Nathan-F04/SaRQ-4th-Year-Project-/Python/yolo/email scripts/example.jpg

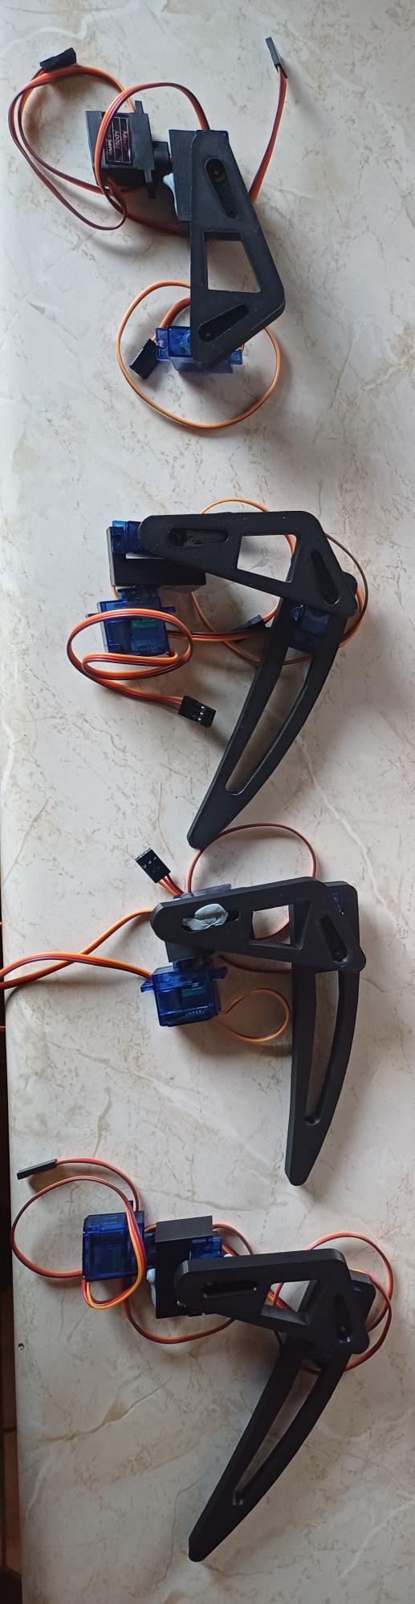
Python/yolo/email scripts/example.jpg
