Nathan-F04/SaRQ-4th-Year-Project-/PDFs/Poster/SaRQ Poster GitHub.pdf

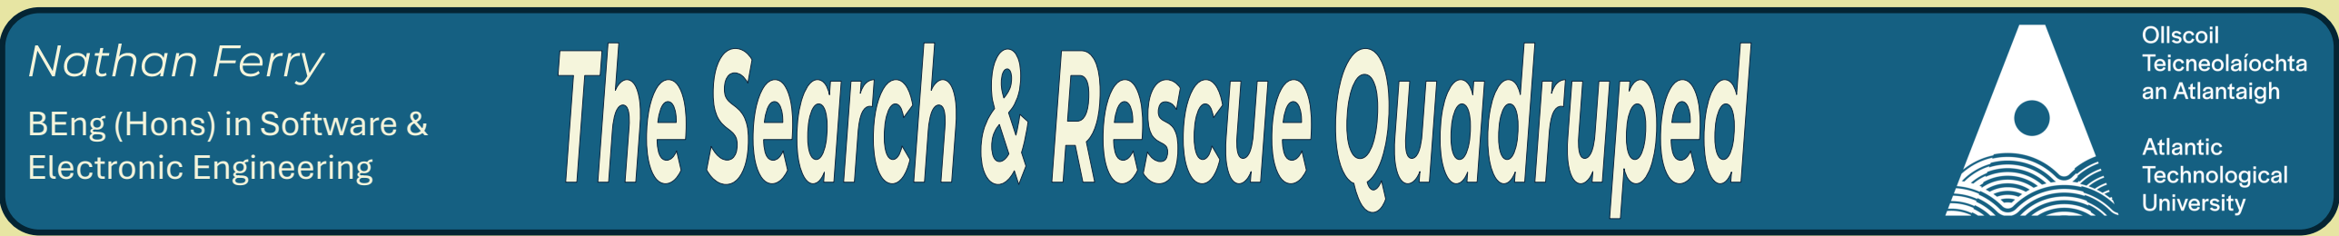
[picture p79: figure]
BEng (Hons) in Software & Electronic Engineering
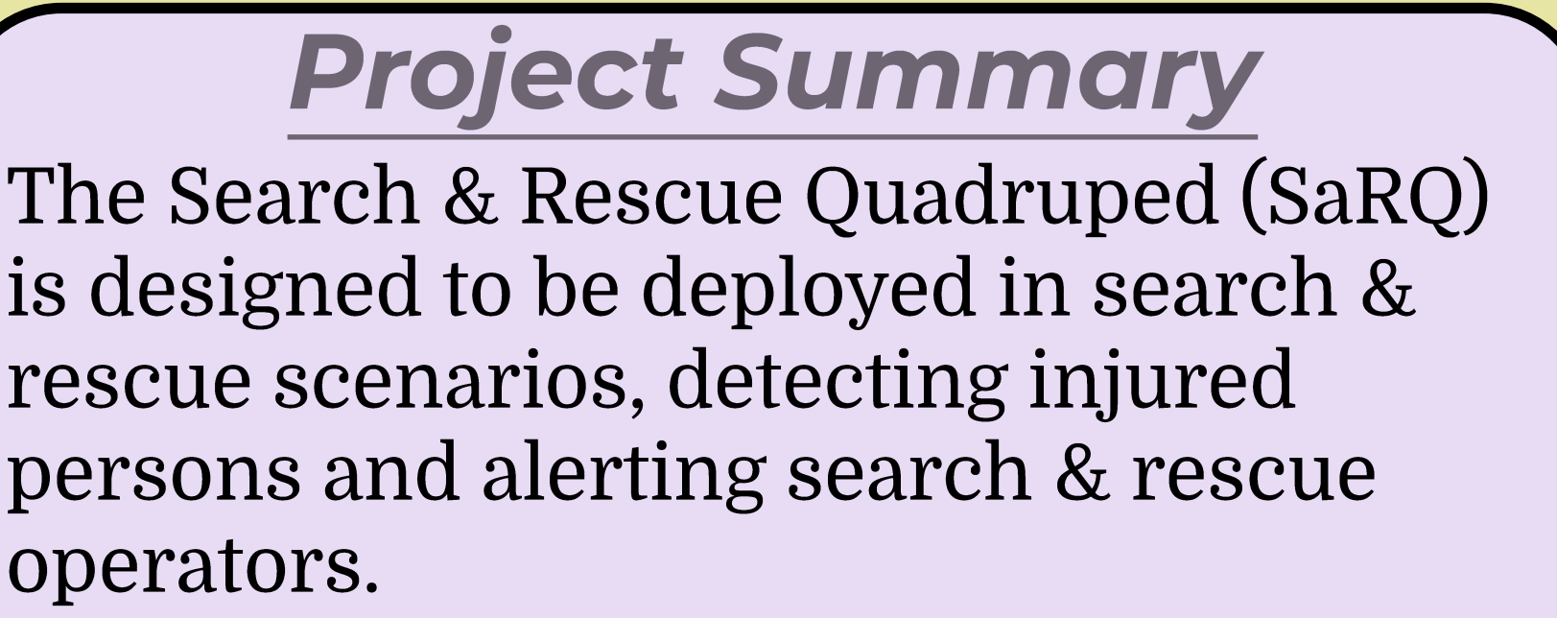
[picture p80: figure]
Project Summary; The Search & Rescue Quadruped (SaRQ) is designed to be deployed in search & rescue scenarios, detecting injured persons and alerting search & rescue operators.

## Architecture Diagram

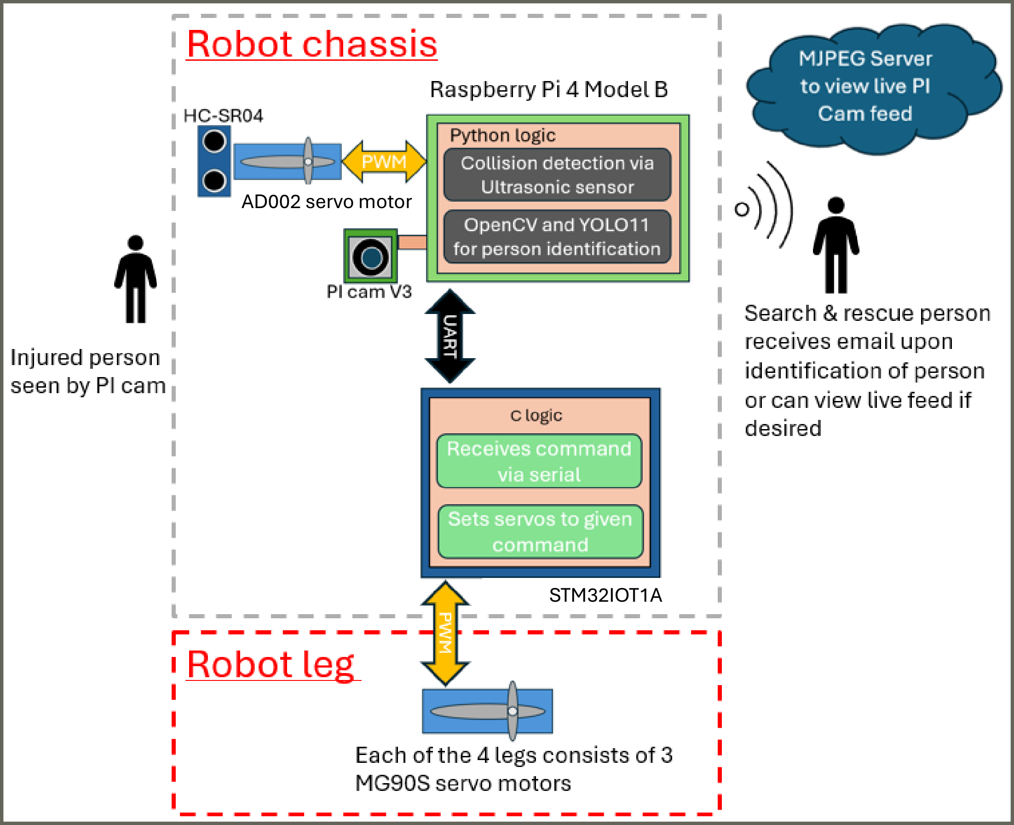
[picture p81: figure]
Yap Yap Yap; STM32IOT1A; AD002 servo motor
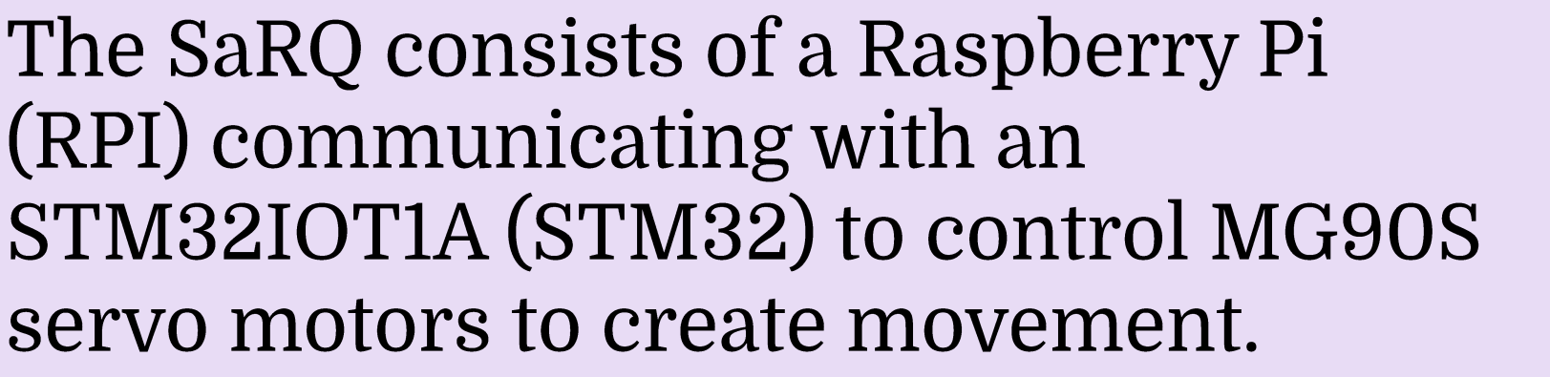
[picture p82: figure]
The SaRQ consists of a Raspberry Pi (RPI) communicating with an STM32IOT1A (STM32) to control MG90S servo motors to create movement.
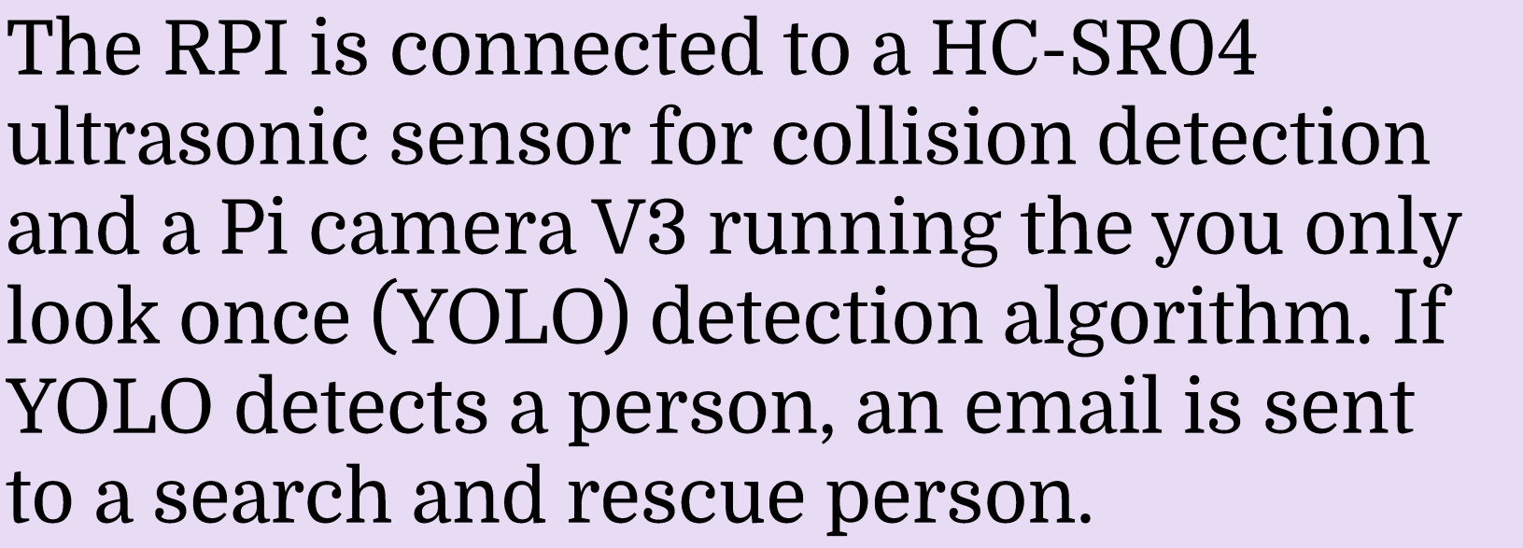
[picture p83: figure]
The RPI is connected to a HC; and a Pi camera V3 running the you only; YOLO detects a person, an email is sent to a search and rescue person.

ultrasonic sensor for collision detection

look once (YOLO) detection algorithm. If

The SaRQ’s live feed through a motion jpeg (MJPEG) server is also available.

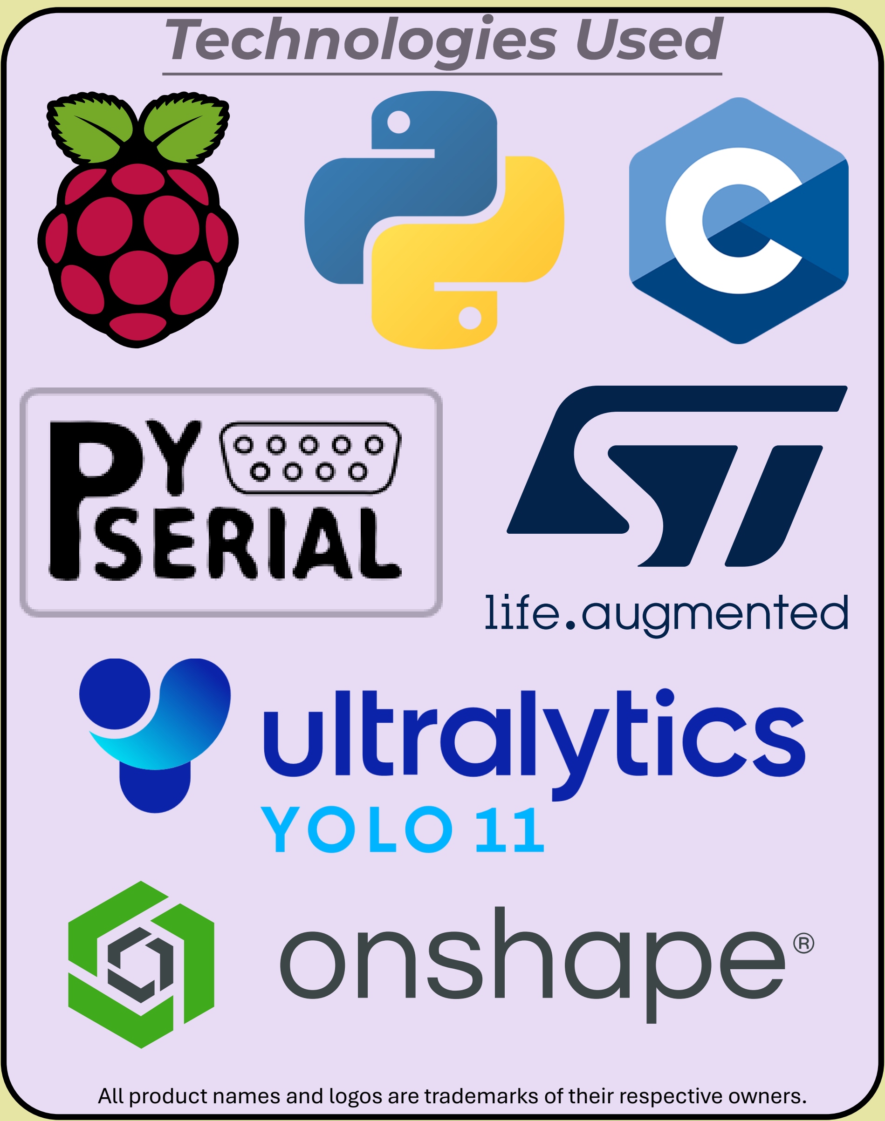
[picture p84: figure]
Technologies Used
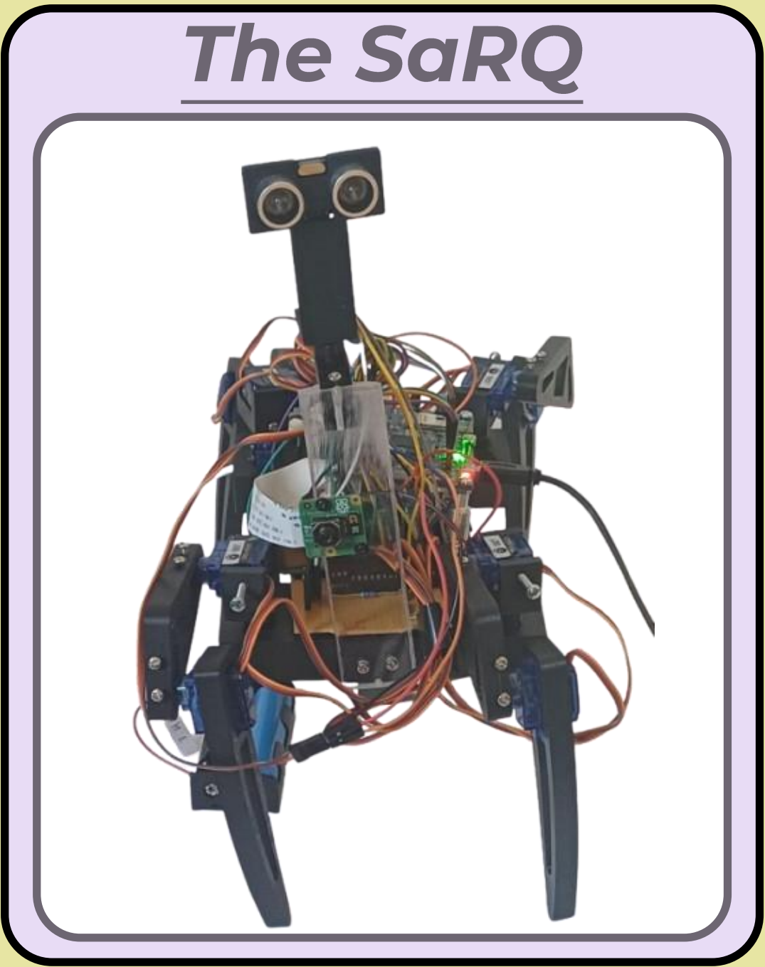
[picture p85: figure]
The SaRQ
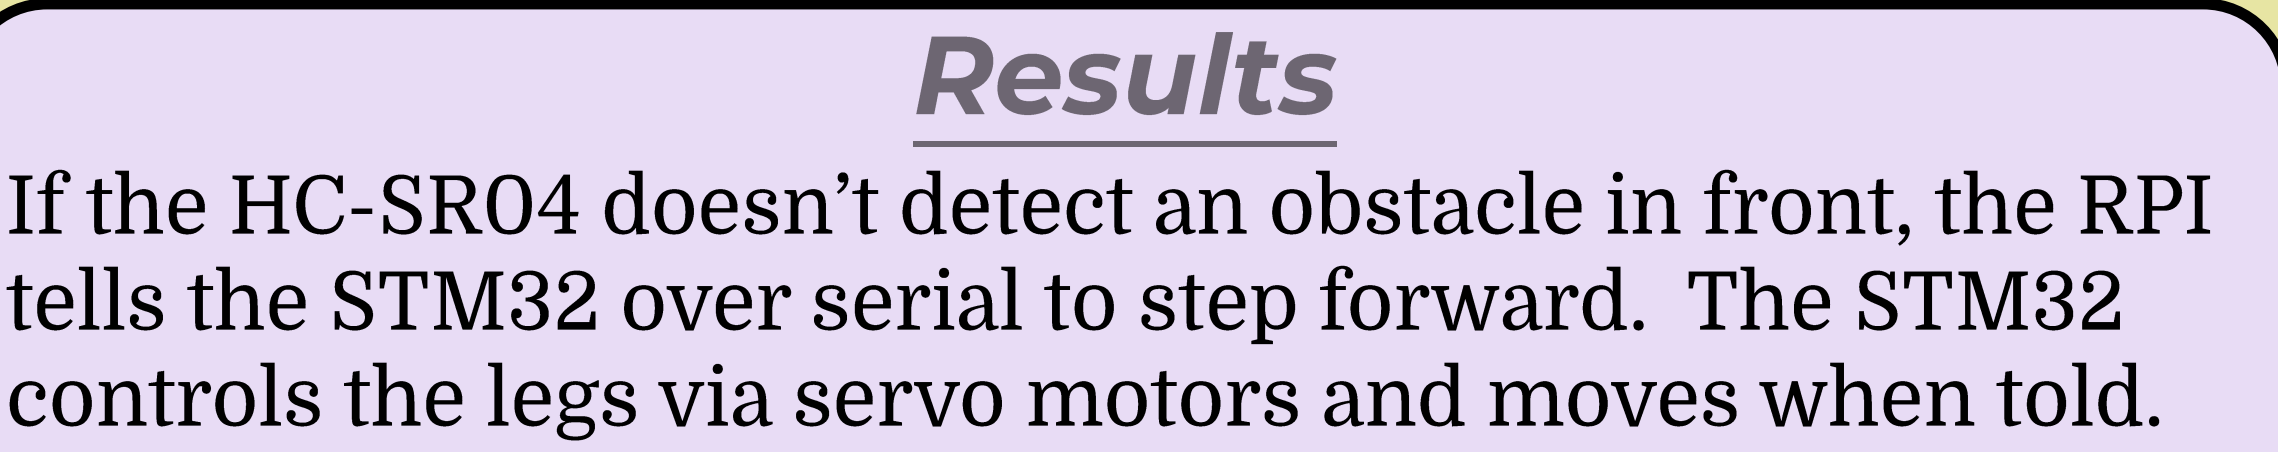
[picture p86: figure]
Results

If the HC -SR04 doesn’t detect an obstacle in front, the RPI tells the STM32 over serial to step forward. The STM32 controls the legs via servo motors and moves when told.

If an obstacle is detected, the HC | -SR04 rotates via an
SG90 servo motor | , taking readings on the left and right of
the SaRQ for the RPI to decide the best direction to move.

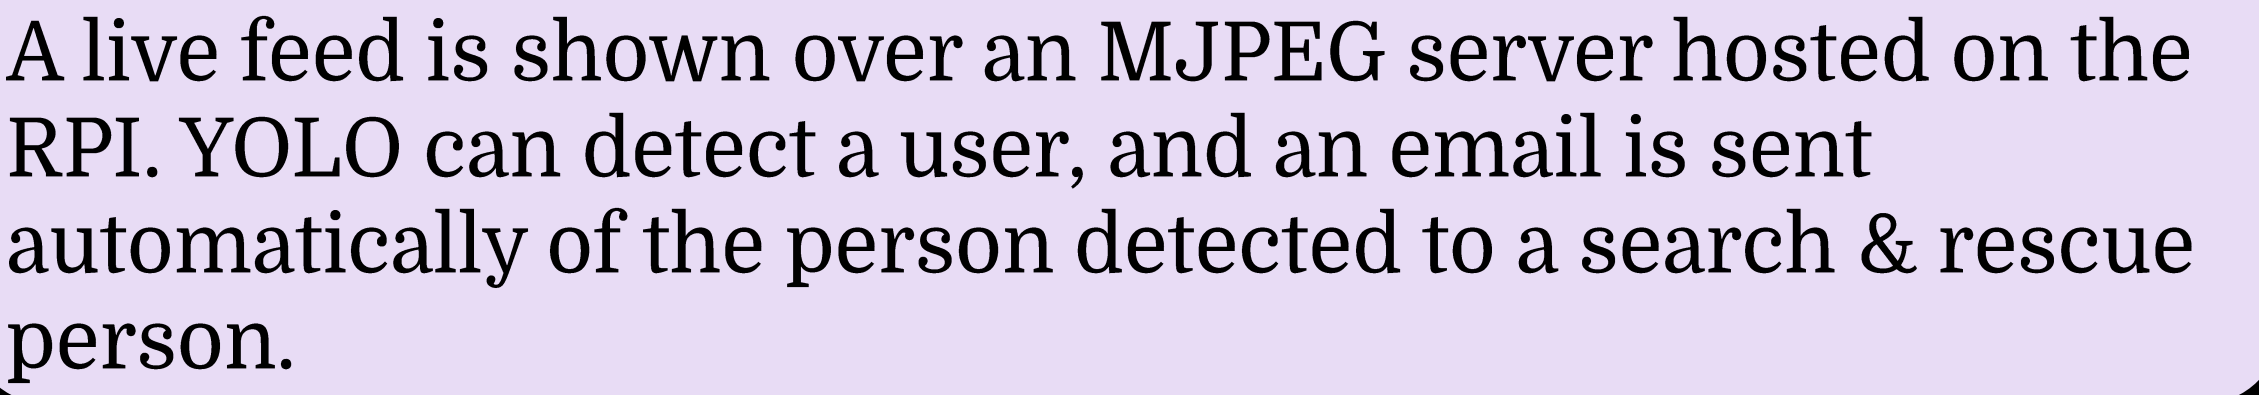
[picture p87: figure]
person.

A live feed is shown over an MJPEG server hosted on the RPI. YOLO can detect a user, and an email is sent automatically of the person detected to a search & rescue

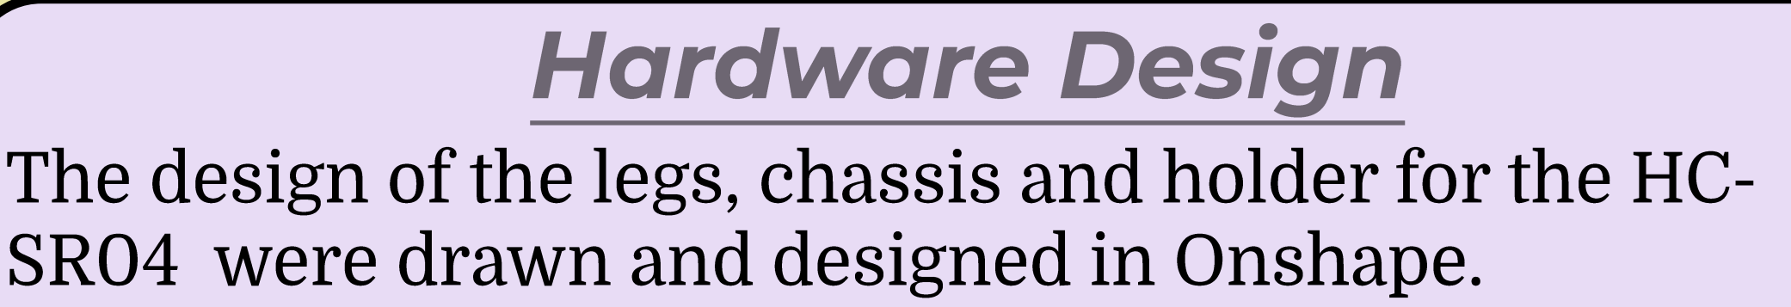
[picture p88: figure]
Hardware Design

The design of the legs, chassis and holder for the HC | -
SR04 were drawn and designed in Onshape.

A Perspex mount holds the Pi camera on the front, along with a servo motor that rotates the HC -SR04.

A series of M3 screws hold the SaRQ, where the holes were drilled and tapped, providing a better grip.

A brown stripboard sits beneath the RPI and STM32, containing a series of headers to help manage the number of servo motor connections, aiding wire management.

The Search & Rescue Quadruped Nathan Ferry

All product names and logos are trademarks of their respective owners.
