Nathan-F04/SaRQ-4th-Year-Project-/PDFs/Presentation Slides/SaRQ presentation.pdf

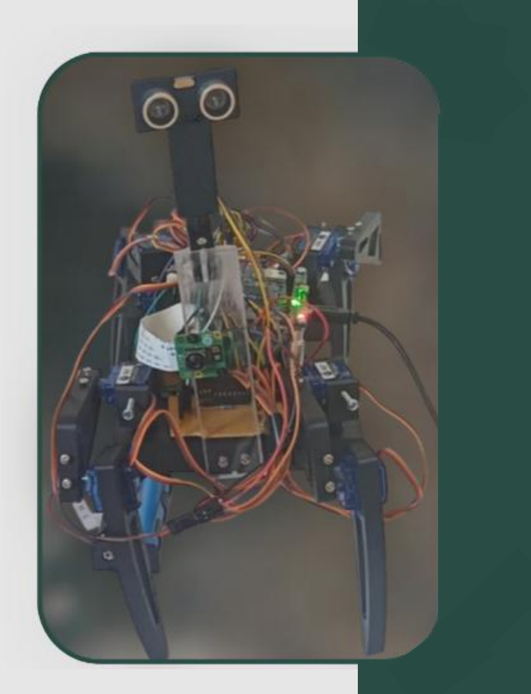
[picture p89: figure]

Nathan Ferry G00413711

# Search & Rescue Quadruped

Final year project demonstration

# System Architecture

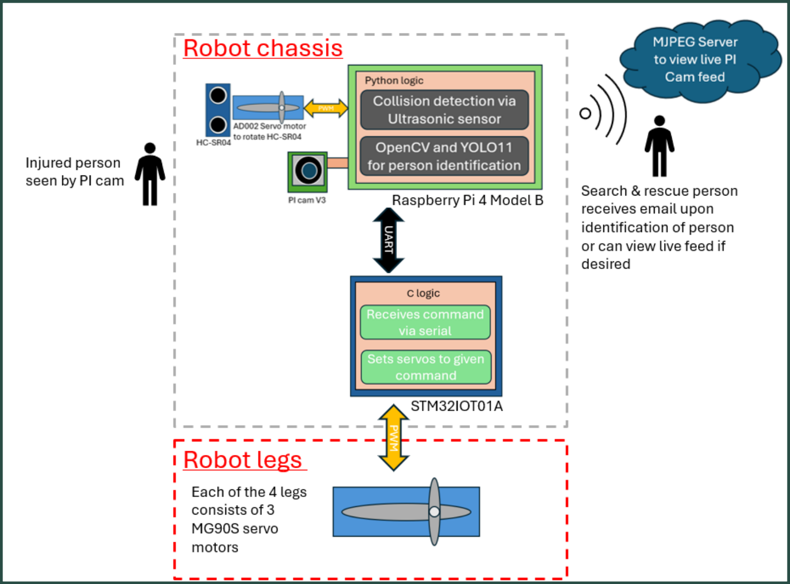
[picture p90: figure]

# YOLO 11

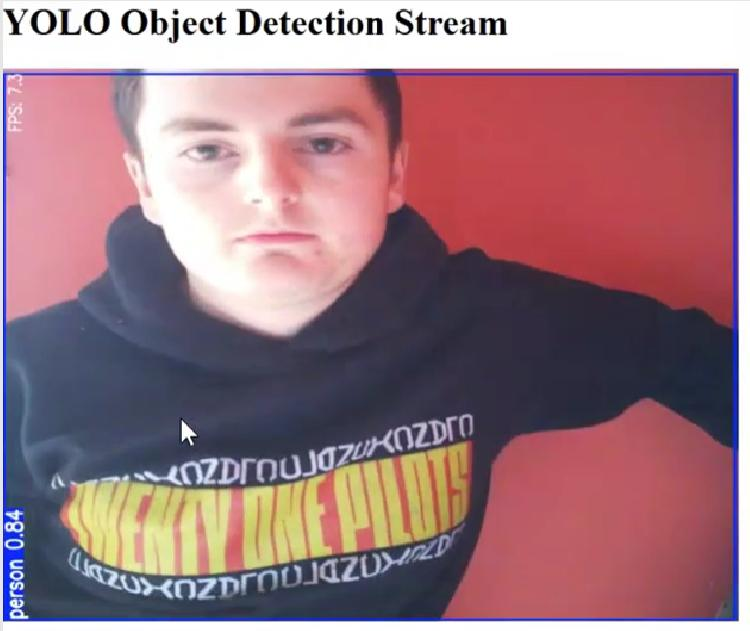
[picture p91: figure]

Residual Blocks

Boundry box regression

Intersection over union (IOU)

Non-max suppression (NMS)

Overall architecture

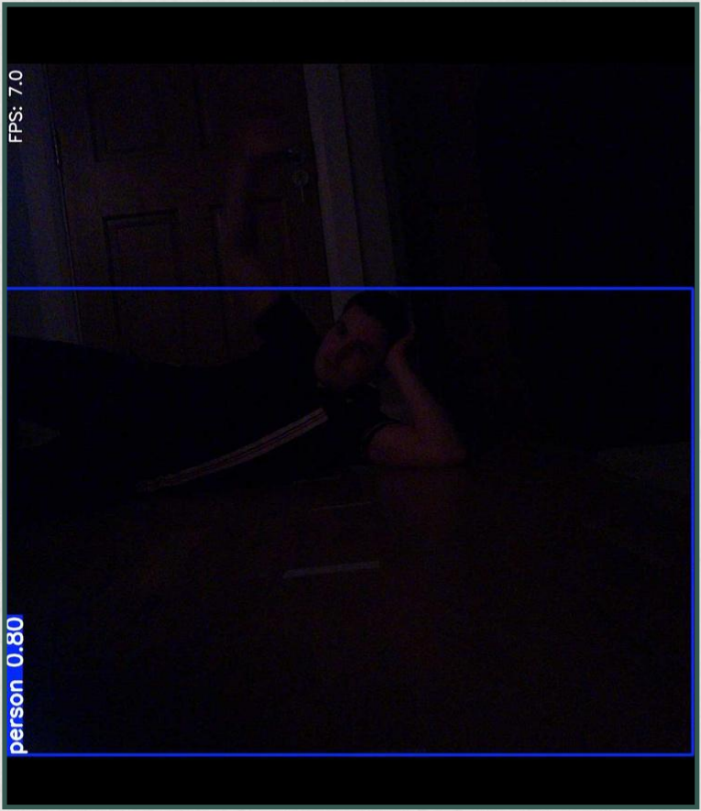
[picture p92: figure]

Motion JPEG (MJPEG) server

Simple mail transfer protocol server (SMTP)

# Alerting Search & Rescue

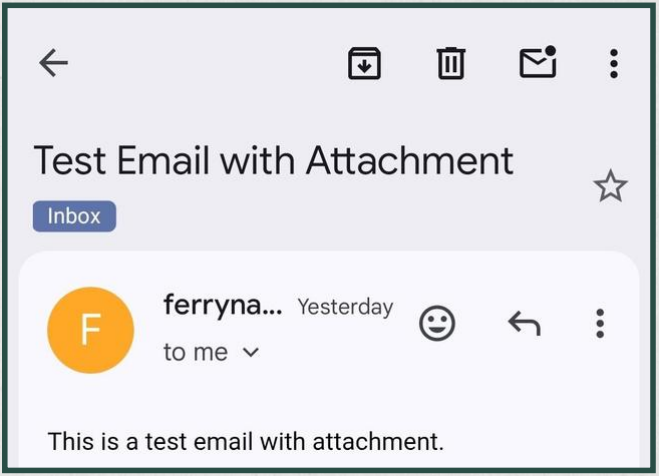
[picture p93: figure]

# Detecting Collisions

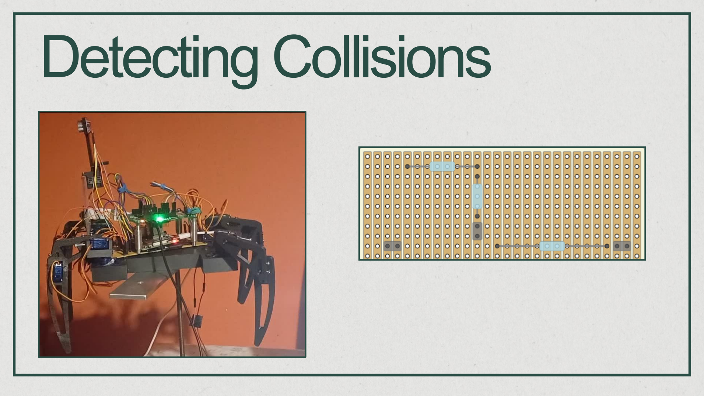
[picture p94: page 5]

# Building the SaRQ

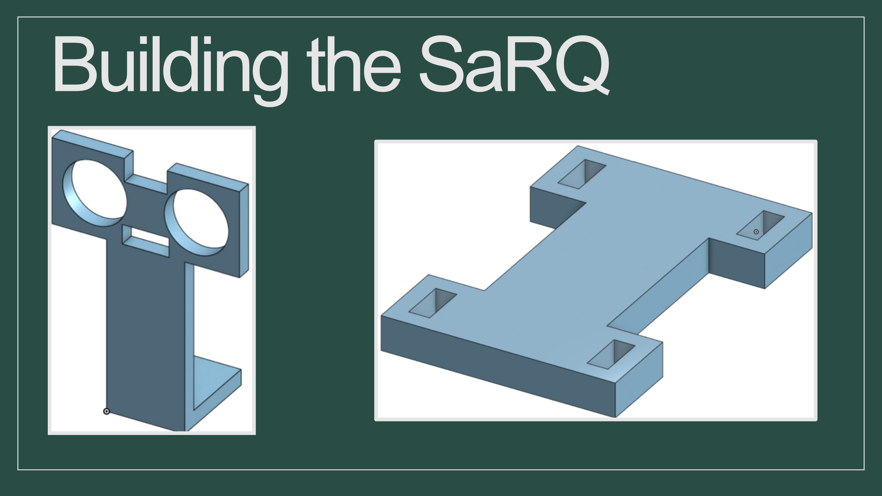
[picture p95: page 6]

# Building the SaRQ

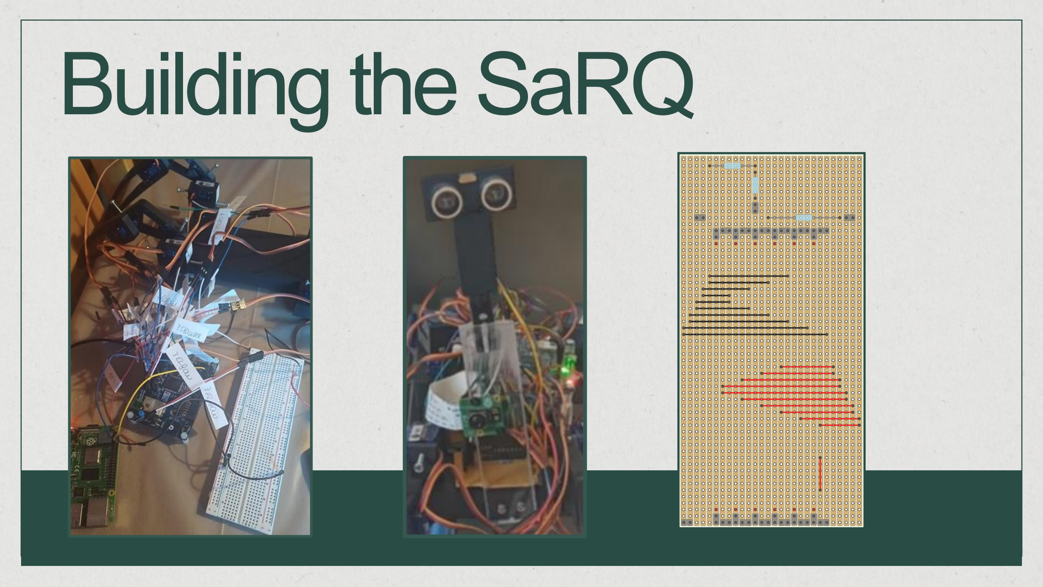
[picture p96: page 7]

# Inverse Kinematics (IK)

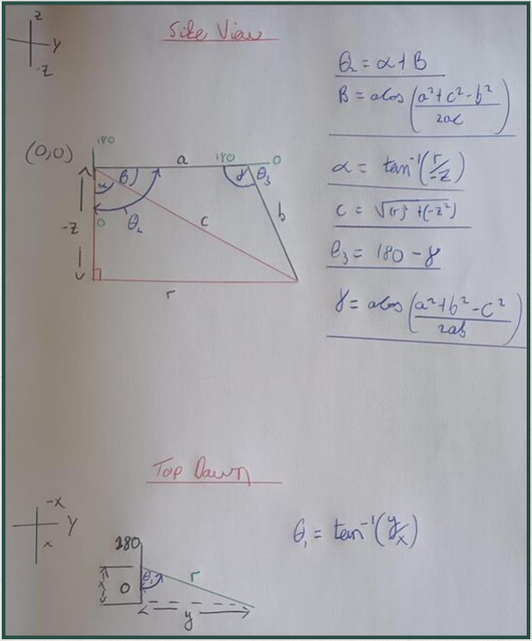
[picture p97: figure]

Tool for creating animations

Trigonometric calculations

What is IK?

# Creating the Animation

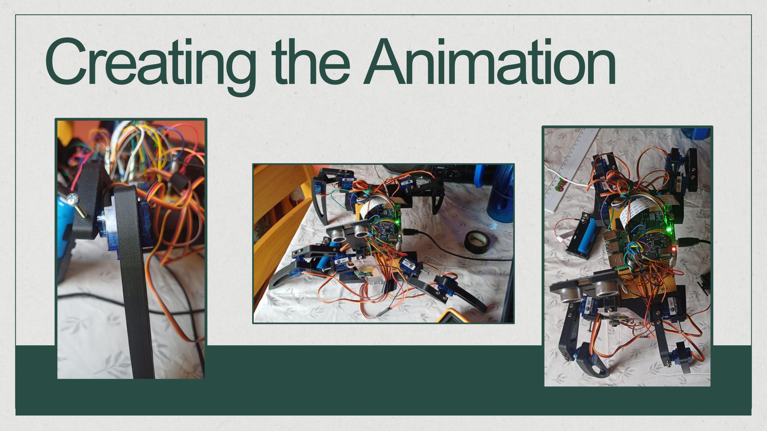
[picture p98: page 9]

YOLO testing | IK Model Testing

# Testing

Facing Camera:
With movement: 0.86
Without movement: 0.75
Covered in “debris”: 0.63

Back to Camera:
With movement: 0.77
Without movement: 0.65
Covered in “debris”: 0.55

X-Axis
10mm - No deviation
39mm - Deviation in Y-Axis (10mm)

Y-Axis
10mm - No deviation
39mm - Deviation in X-Axis (5mm)

OneNote | Jira
GitHub | Weekly stand-ups

# Project Management

# Project Timeline

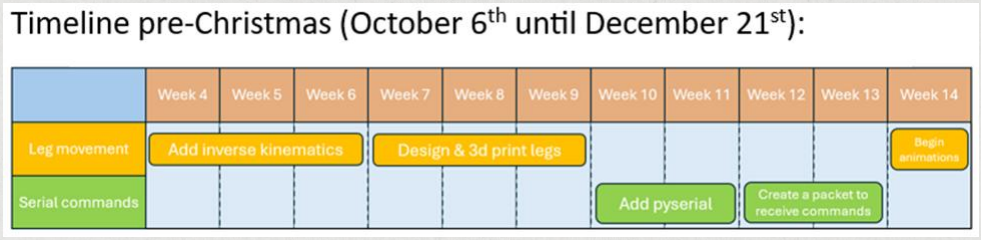
[picture p99: figure]
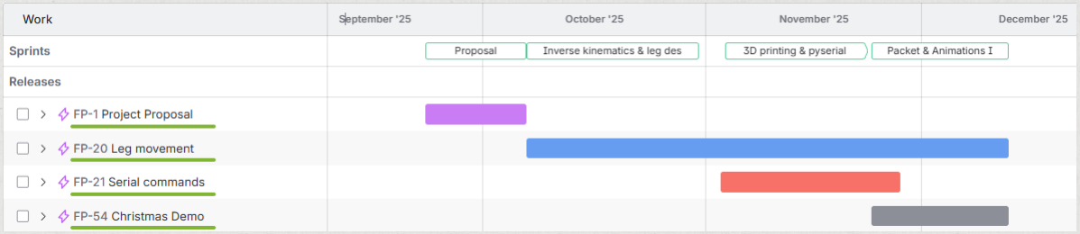
[picture p100: figure]

# Project Timeline

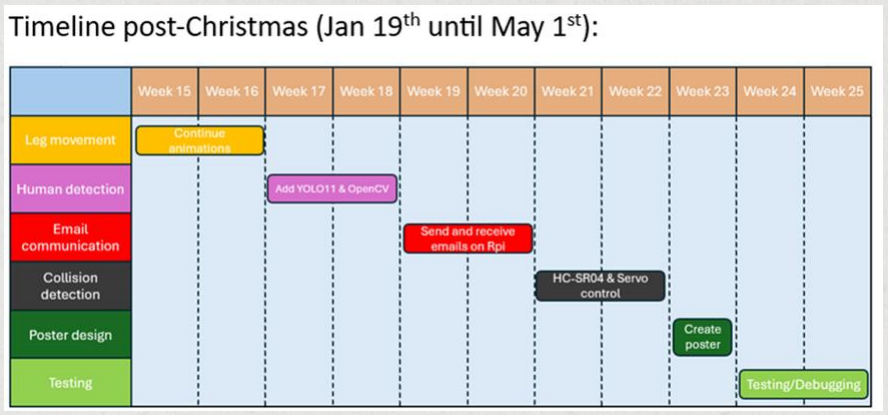
[picture p101: figure]
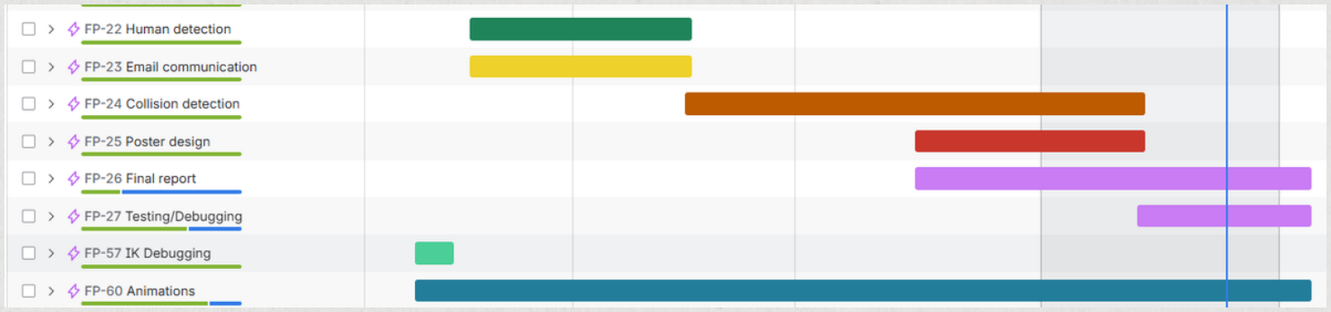
[picture p102: figure]

# Project Timeline

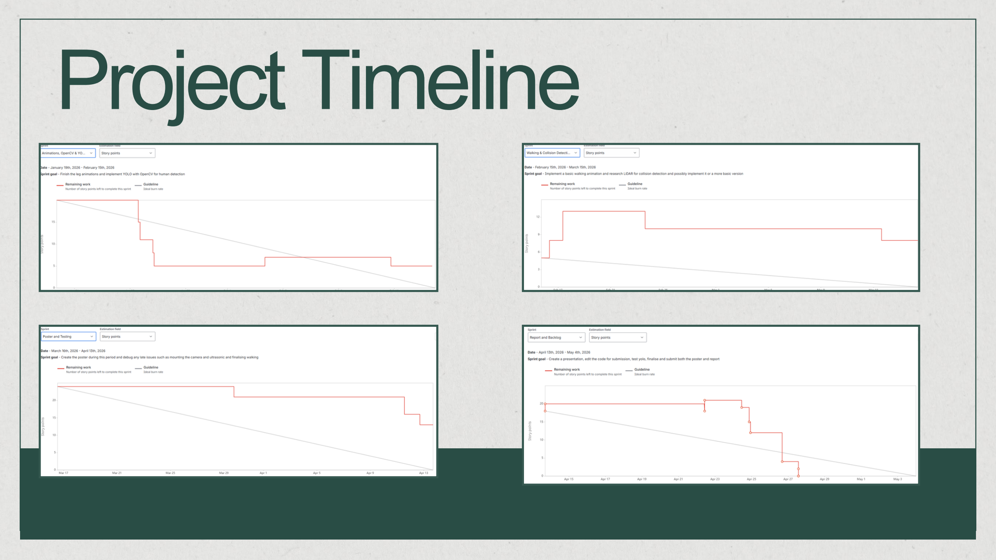
[picture p103: page 14]

# Final Product

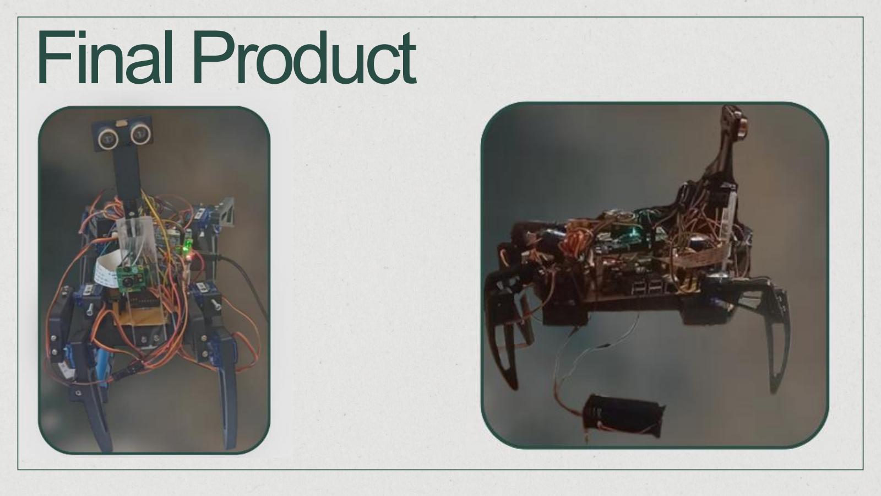
[picture p104: page 15]

# Thank you for listening
