Nathan-F04/SaRQ-4th-Year-Project-/Python/yolo/detect scripts/img/example1.jpg

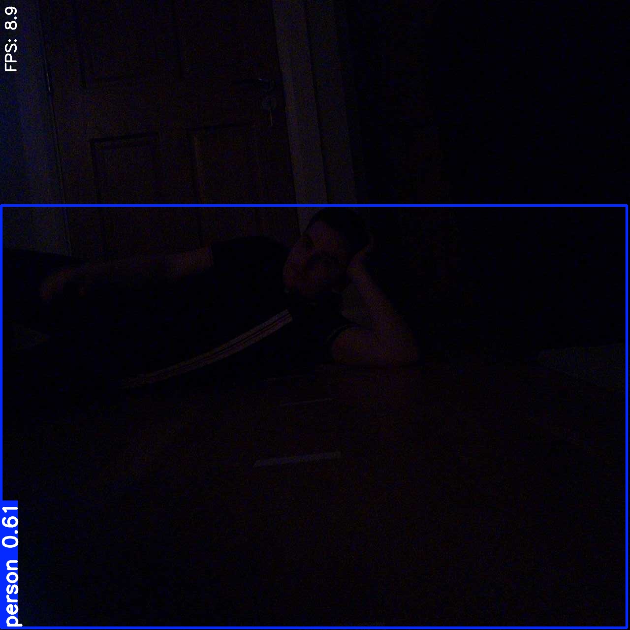
Python/yolo/detect scripts/img/example1.jpg
