Nathan-F04/SaRQ-4th-Year-Project-/STMCode/Bare SARQ/Bare SARQ.ioc

Mcu.UserName=STM32L475VGTx
PA0.Signal=S_TIM5_CH1
PA1.Signal=S_TIM2_CH2
PA2.Signal=S_TIM2_CH3
PA3.Signal=S_TIM5_CH4
PA5.Signal=S_TIM2_CH1
PA6.Signal=S_TIM3_CH1
PA7.Signal=S_TIM3_CH2
PB0.Signal=S_TIM3_CH3
PB1.Signal=S_TIM3_CH4
PB6.Signal=USART1_TX
PB7.Signal=USART1_RX
PB8.Signal=S_TIM16_CH1
PB9.Signal=S_TIM4_CH4
PC4.Signal=USART3_TX
PC5.Signal=USART3_RX
PD14.Signal=S_TIM4_CH3
