Nathan-F04/SaRQ-4th-Year-Project-/STMCode/Bare SARQ/Core/Src/servoPass.c

/*
 * userApp.c
 *
 *  Created on: Dec 8, 2023
 *      Author: Niall.OKeeffe@atu.ie
 */

#include "userApp.h"
#include <stdio.h>

//--------------------------------------------------------------
//used for real time stats, do not delete code from this section
extern TIM_HandleTypeDef htim7;
extern TIM_HandleTypeDef htim2;
extern volatile unsigned long ulHighFrequencyTimerTicks;
void configureTimerForRunTimeStats(void) {
	ulHighFrequencyTimerTicks = 0;
	HAL_TIM_Base_Start_IT(&htim7);
}

unsigned long getRunTimeCounterValue(void) {
	return ulHighFrequencyTimerTicks;
}
//end of real time stats code
//----------------------------------------------------------------

extern UART_HandleTypeDef huart1;

uint8_t flag = 0;
uint32_t pulse_length = 0;

uint16_t servo(uint16_t anglePassed);
// _write function used for printf
int _write(int file, char *ptr, int len) {
	HAL_UART_Transmit(&huart1, (uint8_t*) ptr, len, HAL_MAX_DELAY);
	return len;
}

void userApp() {
	printf("Starting application\r\n\n");
	//Task to pass angle for servo with a simple loop
	uint16_t anglePassed = 0;
	uint32_t CCR_Return = 0;
	TIM2->CCR1 = 0;
	HAL_TIM_PWM_Start(&htim2, TIM_CHANNEL_1);

	while (1) {
		//Get CCR so that each task can assaign based on its own CCR and timer
		anglePassed = 0;
		CCR_Return = servo(anglePassed);
		TIM2->CCR1 = CCR_Return;
		printf("Servo angle is %hu\r\n\n", anglePassed);
		HAL_Delay(2000);
		anglePassed = 180;
		CCR_Return = servo(anglePassed);
		TIM2->CCR1 = CCR_Return;
		printf("Servo angle is %hu\r\n\n", anglePassed);
		HAL_Delay(2000);
	}
}

uint16_t servo(uint16_t anglePassed) {
	//Servo function calculated CCR value and returns it, angle is 210 as it is the servos max.
	uint16_t Min_ARR = 1120, Max_ARR = 8495, AngleRange = 210;
	return ((Max_ARR - Min_ARR) * anglePassed) / AngleRange + Min_ARR;
}
