Nathan-F04/SaRQ-4th-Year-Project-/STMCode/Bare SARQ/Core/Src/basicAnimations.c

/*
 * userApp.c
 *
 *  Created on: Dec 8, 2023
 *      Author: Niall.OKeeffe@atu.ie
 */

#include "userApp.h"
#include <stdio.h>
#include <string.h>
#include <stdlib.h>
#include <string.h>
#include "stm32l4xx_hal.h"
//--------------------------------------------------------------
//used for real time stats, do not delete code from this section
extern TIM_HandleTypeDef htim2;
extern TIM_HandleTypeDef htim3;
extern TIM_HandleTypeDef htim4;
extern TIM_HandleTypeDef htim5;
extern TIM_HandleTypeDef htim7;
extern TIM_HandleTypeDef htim16;

#define CCReg1 1
#define CCReg2 2
#define CCReg3 3
#define CCReg4 4

extern volatile unsigned long ulHighFrequencyTimerTicks;
void configureTimerForRunTimeStats(void) {
	ulHighFrequencyTimerTicks = 0;
	HAL_TIM_Base_Start_IT(&htim7);
}

unsigned long getRunTimeCounterValue(void) {
	return ulHighFrequencyTimerTicks;
}
//end of real time stats code
//----------------------------------------------------------------

extern UART_HandleTypeDef huart1;
extern UART_HandleTypeDef huart3;
// _write function used for printf
int _write(int file, char *ptr, int len) {
	HAL_UART_Transmit(&huart1, (uint8_t*) ptr, len, HAL_MAX_DELAY);
	return len;
}

//uint16_t servo(uint16_t anglePassed);
void servo(uint16_t anglePassed, uint8_t num, TIM_HandleTypeDef *htim);
//uint16_t servo(uint16_t anglePassed);

void userApp() {
	printf("Starting application\r\n\n");
	char rx_buffer[1]; //number + carraige return and newline
	uint8_t msg = 0;

	//pwm starts here and ccrms etc
	//TIM 2
	TIM2->CCR1 = 0;
	TIM2->CCR2 = 0;
	TIM2->CCR3 = 0;
	HAL_TIM_PWM_Start(&htim2, TIM_CHANNEL_1);
	HAL_TIM_PWM_Start(&htim2, TIM_CHANNEL_2);
	HAL_TIM_PWM_Start(&htim2, TIM_CHANNEL_3);

	//TIM 3
	TIM3->CCR1 = 0;
	TIM3->CCR2 = 0;
	TIM3->CCR3 = 0;
	TIM3->CCR4 = 0;
	HAL_TIM_PWM_Start(&htim3, TIM_CHANNEL_1);
	HAL_TIM_PWM_Start(&htim3, TIM_CHANNEL_2);
	HAL_TIM_PWM_Start(&htim3, TIM_CHANNEL_3);
	HAL_TIM_PWM_Start(&htim3, TIM_CHANNEL_4);

	//TIM 4
	TIM4->CCR3 = 0;
	TIM4->CCR4 = 0;
	HAL_TIM_PWM_Start(&htim4, TIM_CHANNEL_3);
	HAL_TIM_PWM_Start(&htim4, TIM_CHANNEL_4);

	//TIM 5
	TIM5->CCR1 = 0;
	TIM5->CCR4 = 0;
	HAL_TIM_PWM_Start(&htim5, TIM_CHANNEL_1);
	HAL_TIM_PWM_Start(&htim5, TIM_CHANNEL_4);

	//TIM 16
	TIM16->CCR1 = 0;
	HAL_TIM_PWM_Start(&htim16, TIM_CHANNEL_1);
	TIM2->CCR1 = 0;
	HAL_TIM_PWM_Start(&htim2, TIM_CHANNEL_1);

	//Default state for all legs
	//Front left leg
	//Hip TIM16 CH1
	servo(90, CCReg1, &htim16);
	//Shoulder TIM4 CH4
	servo(89, CCReg4, &htim4);
	//Elbow TIM2 CH1
	servo(117, CCReg1, &htim2);

	//Front right leg
	//Hip TIM3 CH1
	servo(90, CCReg1, &htim3);
	//Shoulder TIM3 CH2
	servo(89, CCReg2, &htim3);
	//Elbow TIM2 CH3
	servo(117, CCReg3, &htim2);

	//Rear left
	//Hip TIM3 CH4
	servo(90, CCReg4, &htim3);
	//Shoulder TIM5 CH4
	servo(89, CCReg4, &htim5);
	//Elbow TIM3 CH3
	servo(117, CCReg3, &htim3);

	//Rear right
	//Hip TIM4 CH3
	servo(90, CCReg3, &htim4);
	//Shoulder TIM5 CH1
	servo(89, CCReg1, &htim5);
	//Elbow TIM2 CH2
	servo(117, CCReg2, &htim2);
	while (1) {
		HAL_UART_Receive(&huart3, (uint8_t*)rx_buffer, sizeof(rx_buffer), HAL_MAX_DELAY);
		printf("Received: %s\r\n", rx_buffer);
		//Read code from atoi
		msg = atoi(rx_buffer);
		//Reset before looping again
		memset(rx_buffer, 0, sizeof(rx_buffer));
		//Case statement to determine movement
		switch (msg) {
		//Forward - prerequiste vals and writes
		case 1:
			printf("1 received, going forward\r\n");
			//Get CCR so that each task can assaign based on its own CCR and timer
			//Set angle passed for each based on ik
			//Start with the forward step before resetting to natural rest position
			//Front left leg
			//Shoulder TIM4 CH4
			servo(, CCReg4, &htim4);
			//Elbow TIM2 CH1
			servo(, CCReg1, &htim2);

			//Front right leg
			//Shoulder TIM3 CH2
			servo(, CCReg2, &htim3);
			//Elbow TIM2 CH3
			servo(, CCReg3, &htim2)

			//Rear left
			//Shoulder TIM5 CH4
			servo(, CCReg4, &htim5);
			//Elbow TIM3 CH3
			servo(, CCReg3, &htim3);

			//Rear right
			//Shoulder TIM5 CH1
			servo(, CCReg1, &htim5)
			//Elbow TIM2 CH2
			servo(, CCReg2, &htim2);

			//Back to the default to crawl forward
			//Front left leg
			//Shoulder TIM4 CH4
			servo(89, CCReg4, &htim4);
			//Elbow TIM2 CH1
			servo(117, CCReg1, &htim2);

			//Front right leg
			//Shoulder TIM3 CH2
			servo(89, CCReg2, &htim3);
			//Elbow TIM2 CH3
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
		switch (channel) {
		case 1:
			TIM5->CCR1 = CCR_Return;
			HAL_Delay(2000);
			break;
		case 4:
			TIM5->CCR4 = CCR_Return;
			HAL_Delay(2000);
			break;
		default:
			break;
		}
	}
	if (htim->Instance == TIM16) {
		TIM16->CCR1 = CCR_Return;
		HAL_Delay(2000);
	}
}
