Nathan-F04/SaRQ-4th-Year-Project-/STMCode/Bare SARQ/Core/Inc/userApp.h

/*
 * userApp.h
 *
 *  Created on: Dec 8, 2023
 *      Author: Niall.OKeeffe@atu.ie
 */

#ifndef INC_USERAPP_H_
#define INC_USERAPP_H_

#include "main.h"

void userApp();	//Application code function
#endif /* INC_USERAPP_H_ */
