Nathan-F04/SaRQ-4th-Year-Project-/(commit log)

2025-10-15 adding python folder and created inverse kinematics structure
2025-10-15 finished inverse kinematics until legs are built
2025-10-19 Creating new dev branch, may be issues with new file names
    [userApp.c, userApp.h]
2025-10-19 changed userapp to test flow
2025-10-23 Servo test script written and servo range found
2025-10-23 new file for the servo angle pass func
2025-10-29 the servo pass example rewritten for non rts
2025-10-29 rewrote servo range test
2025-10-29 modified ioc for pwm
2025-11-06 changed timer configs
2025-11-06 added sample for python serial
2025-11-06 added sample c code for serial comms
2025-11-06 created sample file instead of in userApp
2025-11-09 added carriage return
2025-11-09 baudrate changed somehow, fixed
    [serialSample.py]
2025-11-12 edited ik code for real leg values
2025-11-12 saved serial sample from userapp to the sample file
2025-11-12 added servo pass and serial code together for rough framework
2025-11-12 code works in terms of cases, only issue is & terminal printing
    [userApp.c]
2025-11-13 Set msg variable to 0 to fix formatting errors
    [userApp.c]
2025-11-13 found another servo channel while testing the servo
2025-11-13 found new servo range, changed timers in ioc for arr etc
2025-11-14 modified range and passing angle sample code while recalibrating servos
2025-11-14 I now start all pwm channels and have a template for when I'm controlling all movement
2025-11-20 ccr is number for channel and tim passed to servo func
2025-11-26 added defines for CCRegs to pass to servo func
2025-12-12 made prints more readable
2026-01-12 fixed print
2026-01-13 rough framework for animation
2026-01-25 installed ultralytics, yolo11, added sample scripts to convert to ncnn and run model
    [model.ncnn.param]
2026-01-25 changed resolution of model and started capture of single image
    [model.ncnn.param]
2026-02-12 email combined with mjpeg, attaches first 10 images and stops
    [model.ncnn.param]
2026-02-24 Made rough servo and ultrasonic files
2026-02-25 tested ultra & servo with working code
2026-03-13 added servo & ultra functions into the workiing example for yolo
2026-03-13 mergine the collision code with serial script
    [mjpeg_email.py]
2026-03-13 fully integrated & tested serial, servo & HC-SR04
2026-03-13 added uart comms for the RPI
2026-04-26 edits to ultrasonic code, off by one error in mjpeg, code cleanup
    [mjpeg_email.py]
